HMS-RIC/MyRIO_Breakout/README.md

# MyRIO_Breakout
Breakout board for NI MyRIO. Brings to BNC connectors 4 analog out, 4 analog in and 14 digital IO. Includes 2 channels of lick detection, 2 solenoid drivers and 3 LED drivers

 MyRIO Breakout Board Ver. G2a
