HMS-RIC/MyRIO_Breakout/PCB-Eagle/MyRIO_Breakout_Gamma2b.pdf

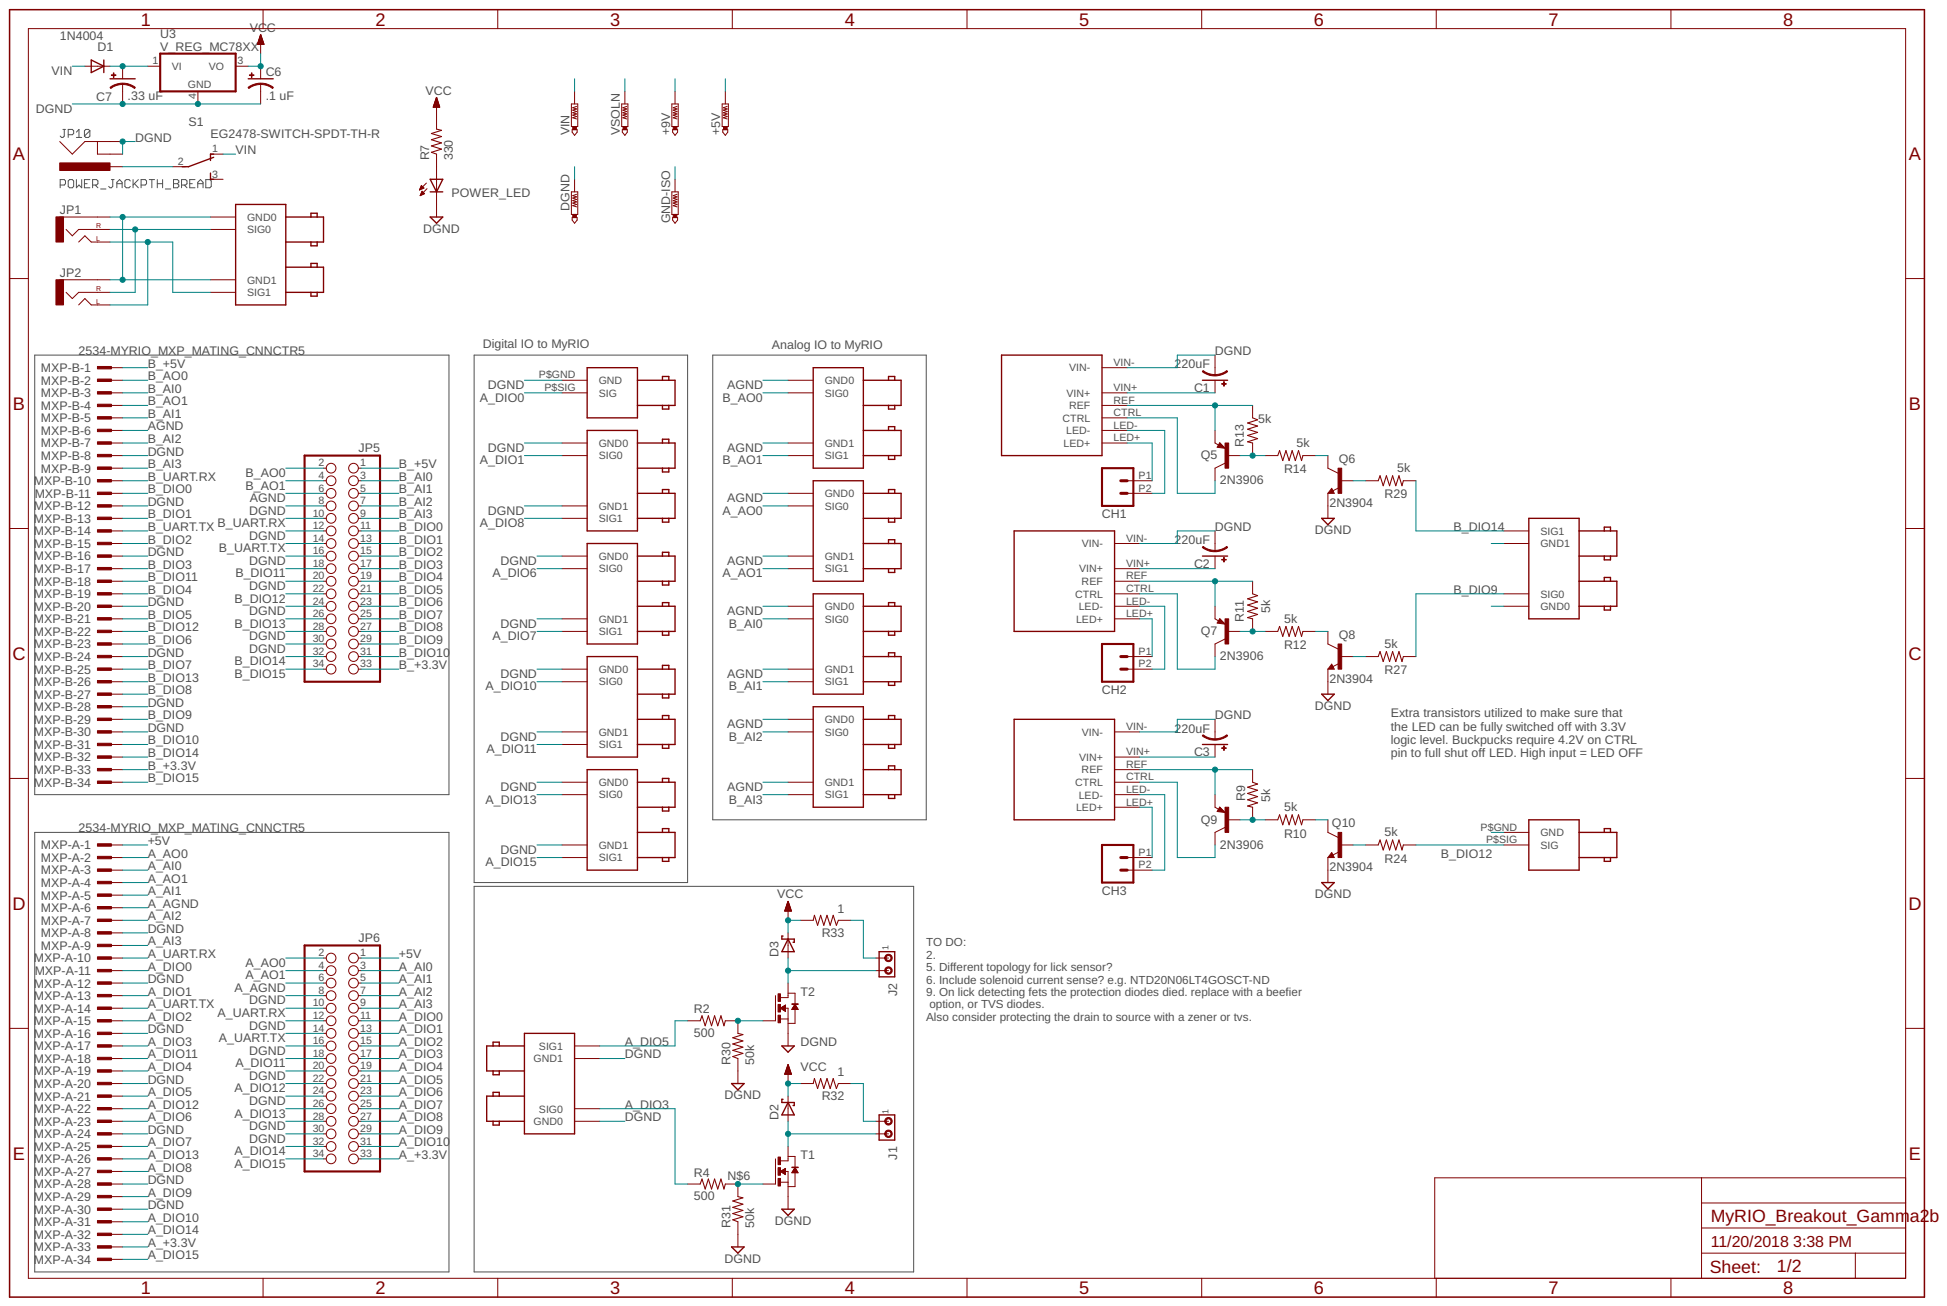
[picture p2: page 1]

1N4004 DGND EG2478-SWITCH-SPDT-TH-R | | | | | DGND

330 Digital IO to MyRIO Analog IO to MyRIO

MXP-B-1 MXP-B-2 MXP-B-3 MXP-B-4 MXP-B-5 MXP-B-6 MXP-B-7 MXP-B-8 MXP-B-9 MXP-B-10 MXP-B-11 MXP-B-12 MXP-B-13 MXP-B-14 MXP-B-15 MXP-B-16 MXP-B-17 MXP-B-18 MXP-B-19 MXP-B-20 MXP-B-21 MXP-B-22 MXP-B-23 MXP-B-24 MXP-B-25 MXP-B-26 MXP-B-27 MXP-B-28 MXP-B-29 MXP-B-30 MXP-B-31 MXP-B-32 MXP-B-33 MXP-B-34

Extra transistors utilized to make sure that
the LED can be fully switched off with 3.3V
logic level. Buckpucks require 4.2V on CTRL
pin to full shut off LED. High input = LED OFF

DGND
B_DIO10
MXP-A-1 MXP-A-2 MXP-A-3 MXP-A-4 MXP-A-5 MXP-A-6 MXP-A-7 MXP-A-8 MXP-A-9 MXP-A-10 MXP-A-11 MXP-A-12 MXP-A-13 MXP-A-14 MXP-A-15 MXP-A-16 MXP-A-17 MXP-A-18 MXP-A-19 MXP-A-20 MXP-A-21 MXP-A-22 MXP-A-23 MXP-A-24 MXP-A-25 MXP-A-26 MXP-A-27 MXP-A-28 MXP-A-29 MXP-A-30 MXP-A-31 MXP-A-32 MXP-A-33 MXP-A-34

TO DO: 2. 5. Different topology for lick sensor?

6. Include solenoid current sense? e.g. NTD20N06LT4GOSCT-ND
9. On lick detecting fets the protection diodes died. replace with a beefier option, or TVS diodes. Also consider protecting the drain to source with a zener or tvs.

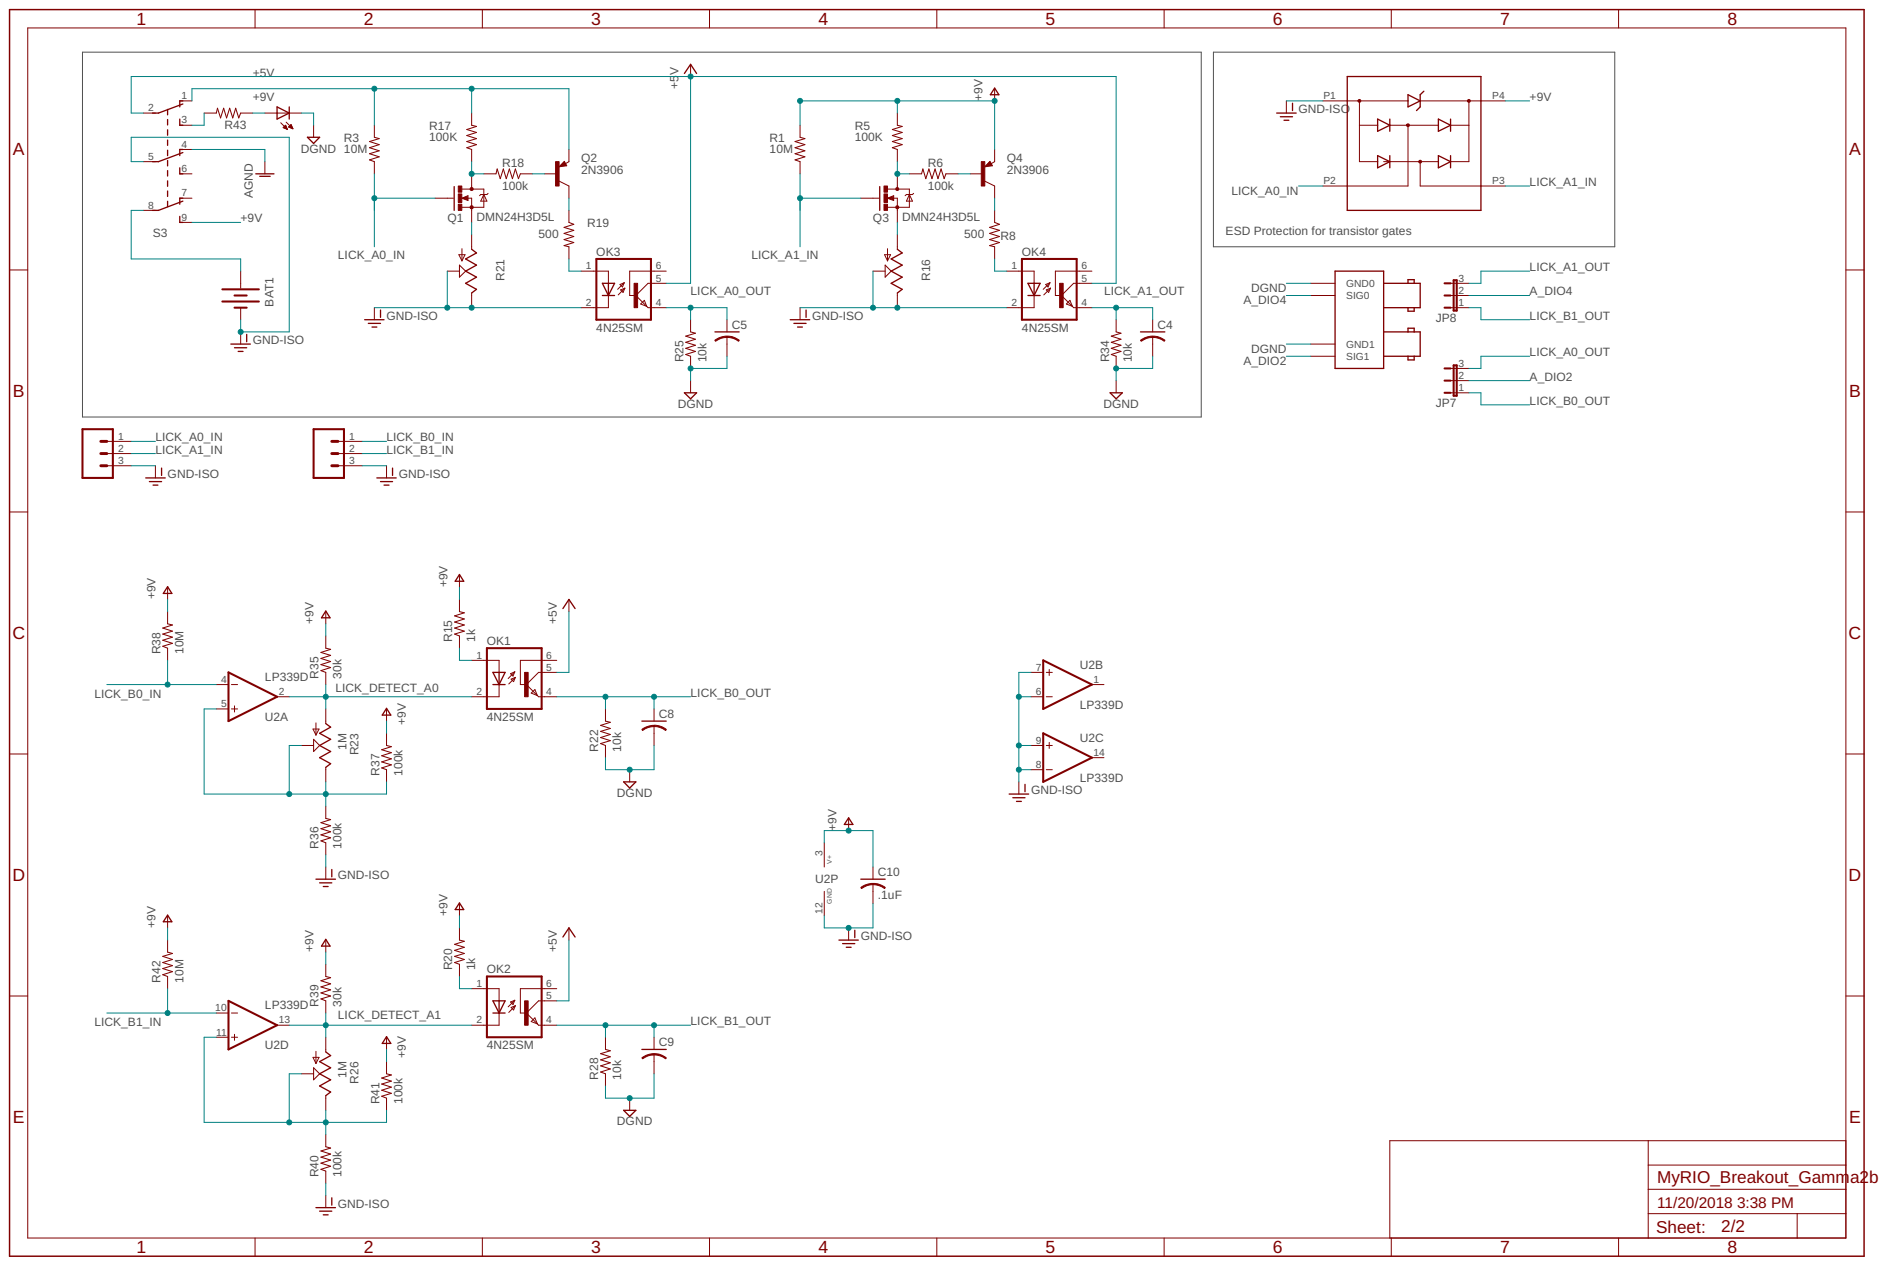
[picture p3: page 2]

ESD Protection for transistor gates BAT1
