HMS-RIC/MyRIO_Breakout/PCB-Eagle/MyRIO_Breakout_Gamma2c_Schematic1.pdf

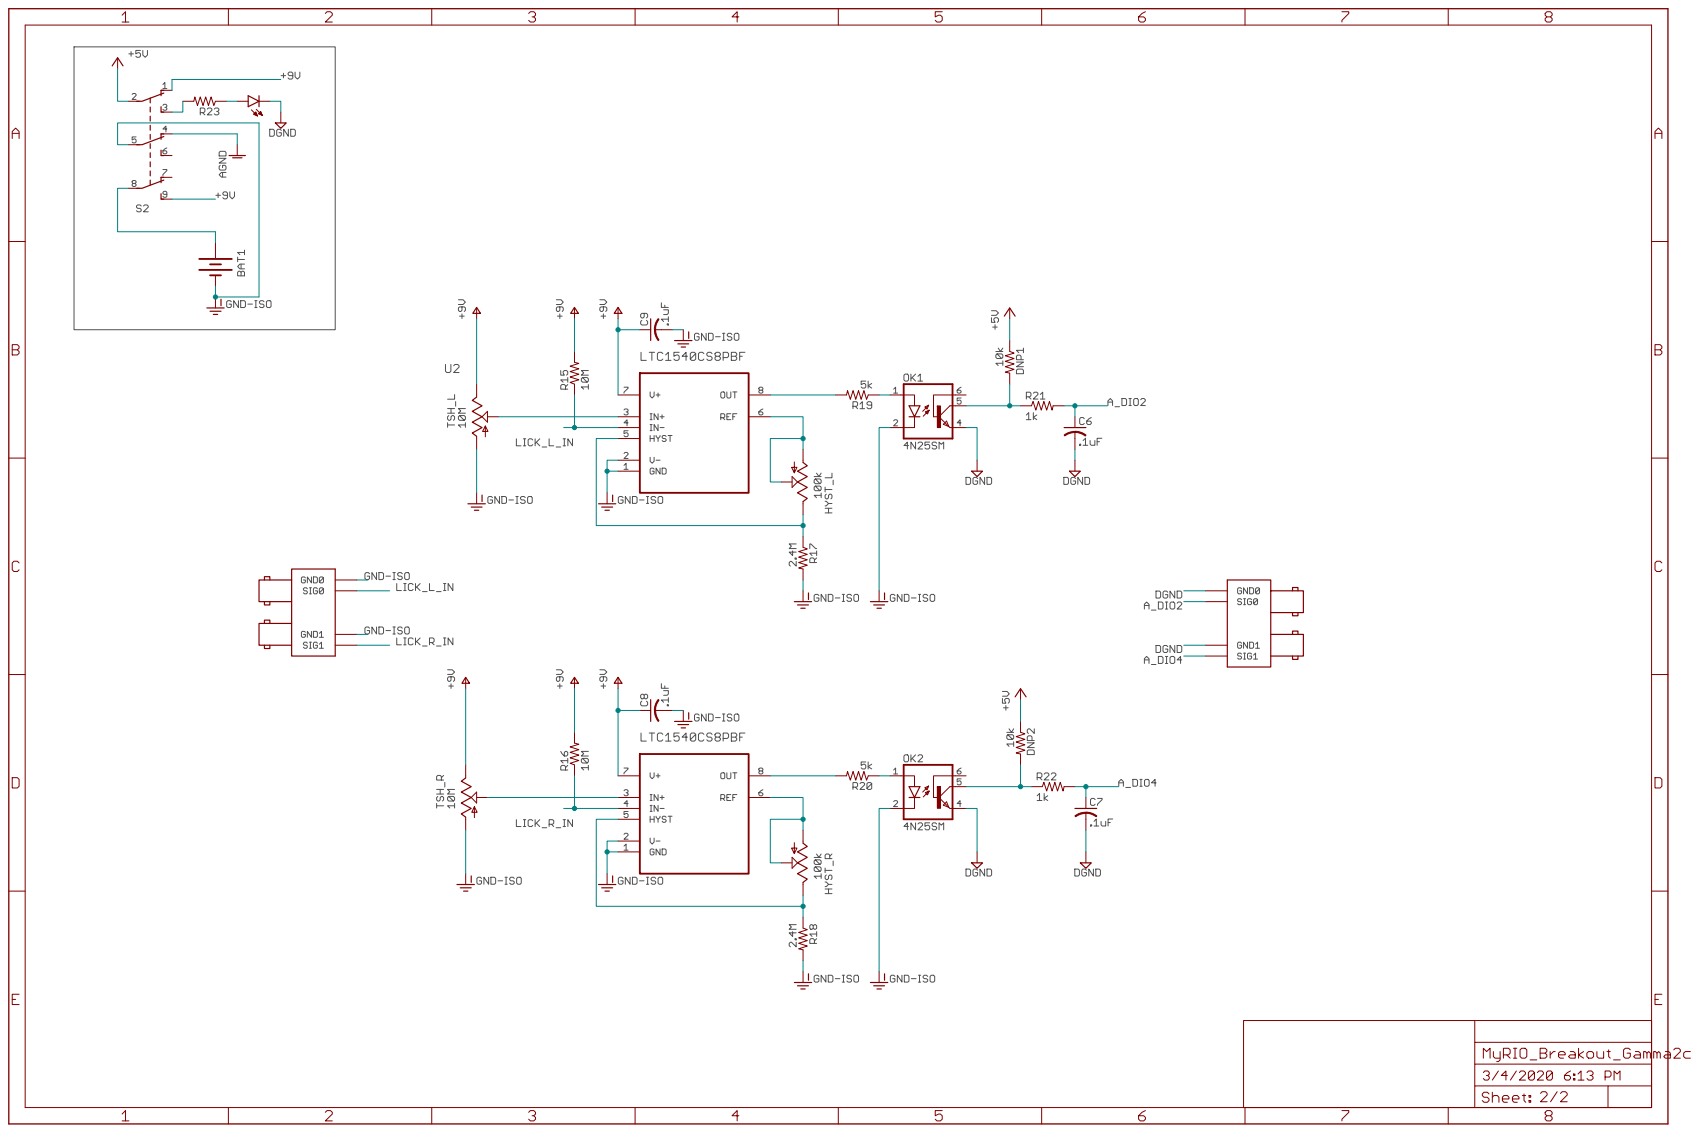
[picture p4: page 1]
