HMS-RIC/MyRIO_Breakout/PCB-Eagle/MyRIO_Breakout_Gamma2c_Schematic2.pdf

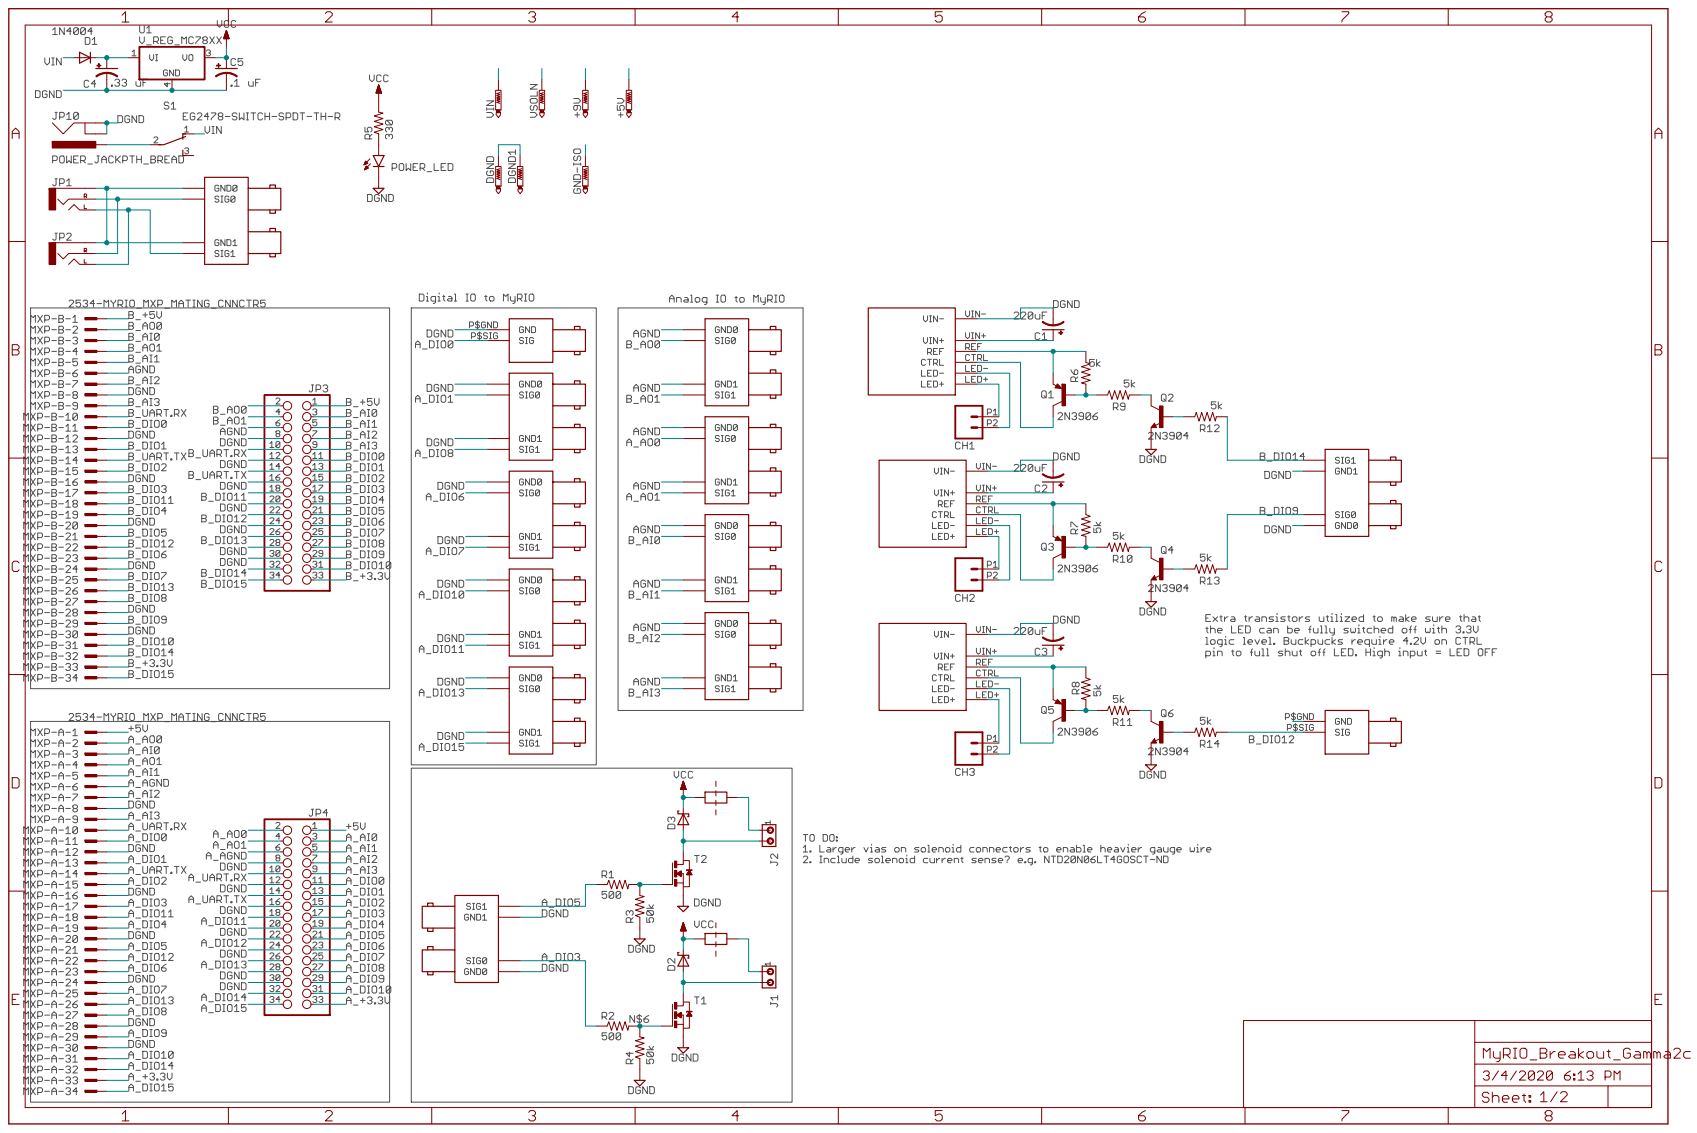
[picture p5: page 1]
