HMS-RIC/MyRIO_Breakout/PCB-Eagle/MyRIO_Breakout_Gamma2d.brd

## EAGLE design PCB-Eagle/MyRIO_Breakout_Gamma2d.brd (2022-01-06)

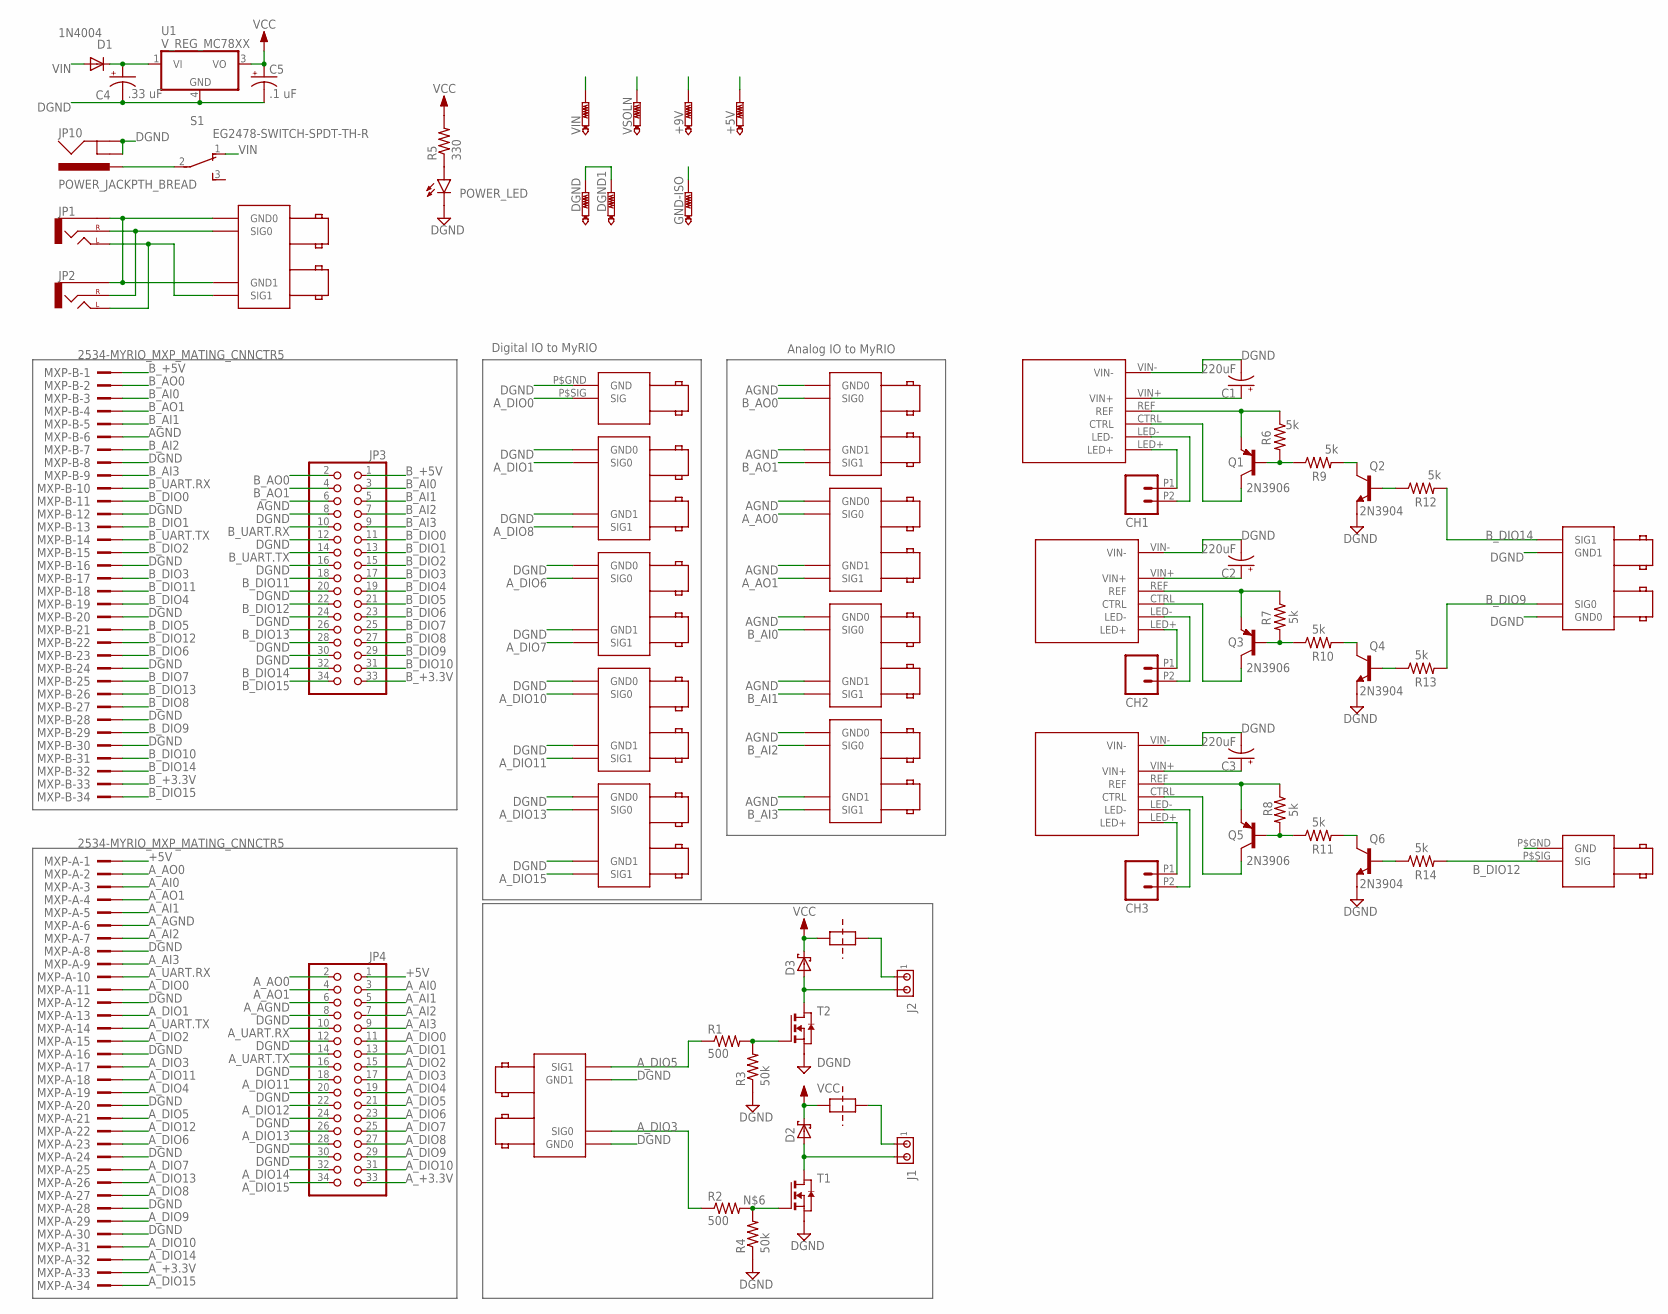
[picture p6: schematic MyRIO_Breakout_Gamma2d.sch, sheet 1]

Parts:
+5V, +9V: PTR1PAD1-13Y; P1-13Y
AAO_0,1: BNC_RIGHT_ANGLE_DOUBLE
ACTV_REC: BNC_RIGHT_ANGLE
AUDIO: BNC_RIGHT_ANGLE_DOUBLE
BAI_0,1, BAI_2,3: BNC_RIGHT_ANGLE_DOUBLE
BAO_0,1: BNC_RIGHT_ANGLE_DOUBLE
BUCKPUCK1, BUCKPUCK2, BUCKPUCK3: BUCKPUCK-350-I; BUCKPUCK_I
C1, C2, C3: 220uF; E5-10,5
C4: .33 uF; E2,5-5
C5: .1 uF; E2,5-5
CAMERA: BNC_RIGHT_ANGLE_DOUBLE
CH1, CH2, CH3: M022.54MM_SCREWTERM; 1X02_2.54_SCREWTERM
D1: 1N4004; DO41-10
D2, D3: SCHOTTKY-DIODE; DIODE_SMB
DGND, DGND1: PTR1PAD1-13Y; P1-13Y
D_FREE1_2, D_FREE3_4: BNC_RIGHT_ANGLE_DOUBLE
GND-ISO: PTR1PAD1-13Y; P1-13Y
J1, J2: MTA02-100; 10X02MTA
JP1, JP2: AUDIO-JACKPTH; AUDIO-JACK
JP3, JP4: PINHD-2X17; 2X17
JP5, JP6: CUTABLE_RESISTOR_JUMPER1206; 1206_WITH_TRACE
JP10: POWER_JACKPTH_BREAD; POWER_JACK_PTH_BREAD
LED_CUE_3: BNC_RIGHT_ANGLE
LED_MASK_1,2: BNC_RIGHT_ANGLE_DOUBLE
MXP-A: 2534-MYRIO_MXP_MATING_CNNCTR5; PAK100/2500-5-34-MXP_CONNCTR
MXP-B: 2534-MYRIO_MXP_MATING_CNNCTR5; PAK100/2500-5-34-MXP_CONNCTR
POWER_LED: LED3MM
Q1, Q3, Q5: 2N3906; SOT23-BEC
Q2, Q4, Q6: 2N3904; SOT23-BEC
R1, R2: 500; M1206
R3, R4: 50k; M1206
R5: 330; 0207/10
R6, R7, R8, R9, R10, R11, R12, R13, R14: 5k; 0805S
S1: EG2478-SWITCH-SPDT-TH-R; ESWITCH_500-SSP1M6
SHUTTER: BNC_RIGHT_ANGLE_DOUBLE
SLN: BNC_RIGHT_ANGLE_DOUBLE
T1, T2: NMOSSOT223; SOT223
U1: V_REG_MC78XX; DPAK
VIN: PTR1PAD1-13Y; P1-13Y
VSOLN: PTR1PAD1-13Y; P1-13Y

Connections:
+5V: +5V.TP, JP4.1, MXP-A.1; also elsewhere on the board
+9V: +9V.TP; also elsewhere on the board
AGND: AAO_0,1.P$GND0 (GND0), AAO_0,1.P$GND1 (GND1), BAI_0,1.P$GND0 (GND0), BAI_0,1.P$GND1 (GND1), BAI_2,3.P$GND0 (GND0), BAI_2,3.P$GND1 (GND1), BAO_0,1.P$GND0 (GND0), BAO_0,1.P$GND1 (GND1), JP3.6, MXP-B.6; also elsewhere on the board
A_+3.3V: JP4.33, MXP-A.33
A_AGND: JP4.6, MXP-A.6
A_AI0: JP4.3, MXP-A.3
A_AI1: JP4.5, MXP-A.5
A_AI2: JP4.7, MXP-A.7
A_AI3: JP4.9, MXP-A.9
A_AO0: AAO_0,1.P$SIG0 (SIG0), JP4.2, MXP-A.2
A_AO1: AAO_0,1.P$SIG1 (SIG1), JP4.4, MXP-A.4
A_DIO0: ACTV_REC.P$SIG (SIG), JP4.11, MXP-A.11
A_DIO1: CAMERA.P$SIG0 (SIG0), JP4.13, MXP-A.13
A_DIO2: JP4.15, MXP-A.15; also elsewhere on the board
A_DIO3: JP4.17, MXP-A.17, R2.1, SLN.P$SIG0 (SIG0)
A_DIO4: JP4.19, MXP-A.19; also elsewhere on the board
A_DIO5: JP4.21, MXP-A.21, R1.1, SLN.P$SIG1 (SIG1)
A_DIO6: JP4.23, MXP-A.23, SHUTTER.P$SIG0 (SIG0)
A_DIO7: JP4.25, MXP-A.25, SHUTTER.P$SIG1 (SIG1)
A_DIO8: CAMERA.P$SIG1 (SIG1), JP4.27, MXP-A.27
A_DIO9: JP4.29, MXP-A.29
A_DIO10: D_FREE1_2.P$SIG0 (SIG0), JP4.31, MXP-A.31
A_DIO11: D_FREE1_2.P$SIG1 (SIG1), JP4.18, MXP-A.18
A_DIO12: JP4.22, MXP-A.22
A_DIO13: D_FREE3_4.P$SIG0 (SIG0), JP4.26, MXP-A.26
A_DIO14: JP4.32, MXP-A.32
A_DIO15: D_FREE3_4.P$SIG1 (SIG1), JP4.34, MXP-A.34
A_UART.RX: JP4.10, MXP-A.10
A_UART.TX: JP4.14, MXP-A.14
BCKPCK_CTRL2: Q4.C, R10.2
BCKPCK_CTRL3: Q6.C, R11.2
B_+3.3V: JP3.33, MXP-B.33
B_+5V: JP3.1, MXP-B.1
B_AI0: BAI_0,1.P$SIG0 (SIG0), JP3.3, MXP-B.3
B_AI1: BAI_0,1.P$SIG1 (SIG1), JP3.5, MXP-B.5
B_AI2: BAI_2,3.P$SIG0 (SIG0), JP3.7, MXP-B.7
B_AI3: BAI_2,3.P$SIG1 (SIG1), JP3.9, MXP-B.9
B_AO0: BAO_0,1.P$SIG0 (SIG0), JP3.2, MXP-B.2
B_AO1: BAO_0,1.P$SIG1 (SIG1), JP3.4, MXP-B.4
B_DIO0: JP3.11, MXP-B.11
B_DIO1: JP3.13, MXP-B.13
B_DIO2: JP3.15, MXP-B.15
B_DIO3: JP3.17, MXP-B.17
B_DIO4: JP3.19, MXP-B.19
B_DIO5: JP3.21, MXP-B.21
B_DIO6: JP3.23, MXP-B.23
B_DIO7: JP3.25, MXP-B.25
B_DIO8: JP3.27, MXP-B.27
B_DIO9: JP3.29, LED_MASK_1,2.P$SIG0 (SIG0), MXP-B.29, R13.2
B_DIO10: JP3.31, MXP-B.31
B_DIO11: JP3.18, MXP-B.18
B_DIO12: JP3.22, LED_CUE_3.P$SIG (SIG), MXP-B.22, R14.2
B_DIO13: JP3.26, MXP-B.26
B_DIO14: JP3.32, LED_MASK_1,2.P$SIG1 (SIG1), MXP-B.32, R12.2
B_DIO15: JP3.34, MXP-B.34
B_UART.RX: JP3.10, MXP-B.10
B_UART.TX: JP3.14, MXP-B.14
CTRL1: BUCKPUCK1.CTRL, Q1.C
CTRL2: BUCKPUCK2.CTRL, Q3.C
CTRL3: BUCKPUCK3.CTRL, Q5.C
DGND: ACTV_REC.P$GND (GND), BUCKPUCK1.LED-, BUCKPUCK1.VIN-, BUCKPUCK2.LED-, BUCKPUCK2.VIN-, BUCKPUCK3.LED-, BUCKPUCK3.VIN-, C1.-, C2.-, C3.-, C4.-, C5.-, CAMERA.P$GND0 (GND0), CAMERA.P$GND1 (GND1), CH1.P2 (2), CH2.P2 (2), CH3.P2 (2), DGND.TP, DGND1.TP, D_FREE1_2.P$GND0 (GND0), D_FREE1_2.P$GND1 (GND1), D_FREE3_4.P$GND0 (GND0), D_FREE3_4.P$GND1 (GND1), JP3.8, JP3.12, JP3.16, JP3.20, JP3.24, JP3.28, JP3.30, JP4.8, JP4.12, JP4.16, JP4.20, JP4.24, JP4.28, JP4.30, JP10.GND, JP10.GNDBREAK, LED_CUE_3.P$GND (GND), LED_MASK_1,2.P$GND0 (GND0), LED_MASK_1,2.P$GND1 (GND1), MXP-A.8, MXP-A.12, MXP-A.16, MXP-A.20, MXP-A.24, MXP-A.28, MXP-A.30, MXP-B.8, MXP-B.12, MXP-B.16, MXP-B.20, MXP-B.24, MXP-B.28, MXP-B.30, POWER_LED.K (C), Q2.E, Q4.E, Q6.E, R3.1, R4.1, SHUTTER.P$GND0 (GND0), SHUTTER.P$GND1 (GND1), SLN.P$GND0 (GND0), SLN.P$GND1 (GND1), T1.3 (S), T2.3 (S), U1.4 (GND); also elsewhere on the board
GND-ISO: GND-ISO.TP; also elsewhere on the board
LED1+: BUCKPUCK1.LED+, CH1.P1 (1)
LED2+: BUCKPUCK2.LED+, CH2.P1 (1)
LED3+: BUCKPUCK3.LED+, CH3.P1 (1)
unnamed: R1.2, R3.2, T2.1 (G)
unnamed: AUDIO.P$GND0 (GND0), AUDIO.P$GND1 (GND1), JP1.SLEEVE, JP2.SLEEVE
unnamed: AUDIO.P$SIG0 (SIG0), JP1.RING (RIGHT), JP2.RING (RIGHT)
unnamed: AUDIO.P$SIG1 (SIG1), JP1.TIP (LEFT), JP2.TIP (LEFT)
unnamed: R2.2, R4.2, T1.1 (G)
unnamed: BUCKPUCK3.REF, Q5.E, R8.1
unnamed: POWER_LED.A, R5.1
unnamed: Q5.B, R8.2, R11.1
unnamed: BUCKPUCK1.VIN+, BUCKPUCK2.VIN+, BUCKPUCK3.VIN+, C1.+, C2.+, C3.+, C4.+, D1.C, U1.1 (VI), VIN.TP
unnamed: BUCKPUCK1.REF, Q1.E, R6.1
unnamed: BUCKPUCK2.REF, Q3.E, R7.1
unnamed: Q6.B, R14.1
unnamed: Q4.B, R13.1
unnamed: Q1.B, R6.2, R9.1
unnamed: Q2.B, R12.1
unnamed: J1.1, JP6.2
unnamed: Q3.B, R7.2, R10.1
unnamed: JP10.PWR, S1.2
unnamed: J2.1, JP5.2
unnamed: Q2.C, R9.2
VCC: C5.+, D2.C (A), D3.C (A), JP5.1, JP6.1, R5.2, U1.3 (VO), VSOLN.TP
VIN: D1.A, S1.1
VOUT-1: D2.A (C), J1.2, T1.2 (D), T1.4 (D)
VOUT-2: D3.A (C), J2.2, T2.2 (D), T2.4 (D)

Notes on the sheet:
Digital IO to MyRIO
Analog IO to MyRIO

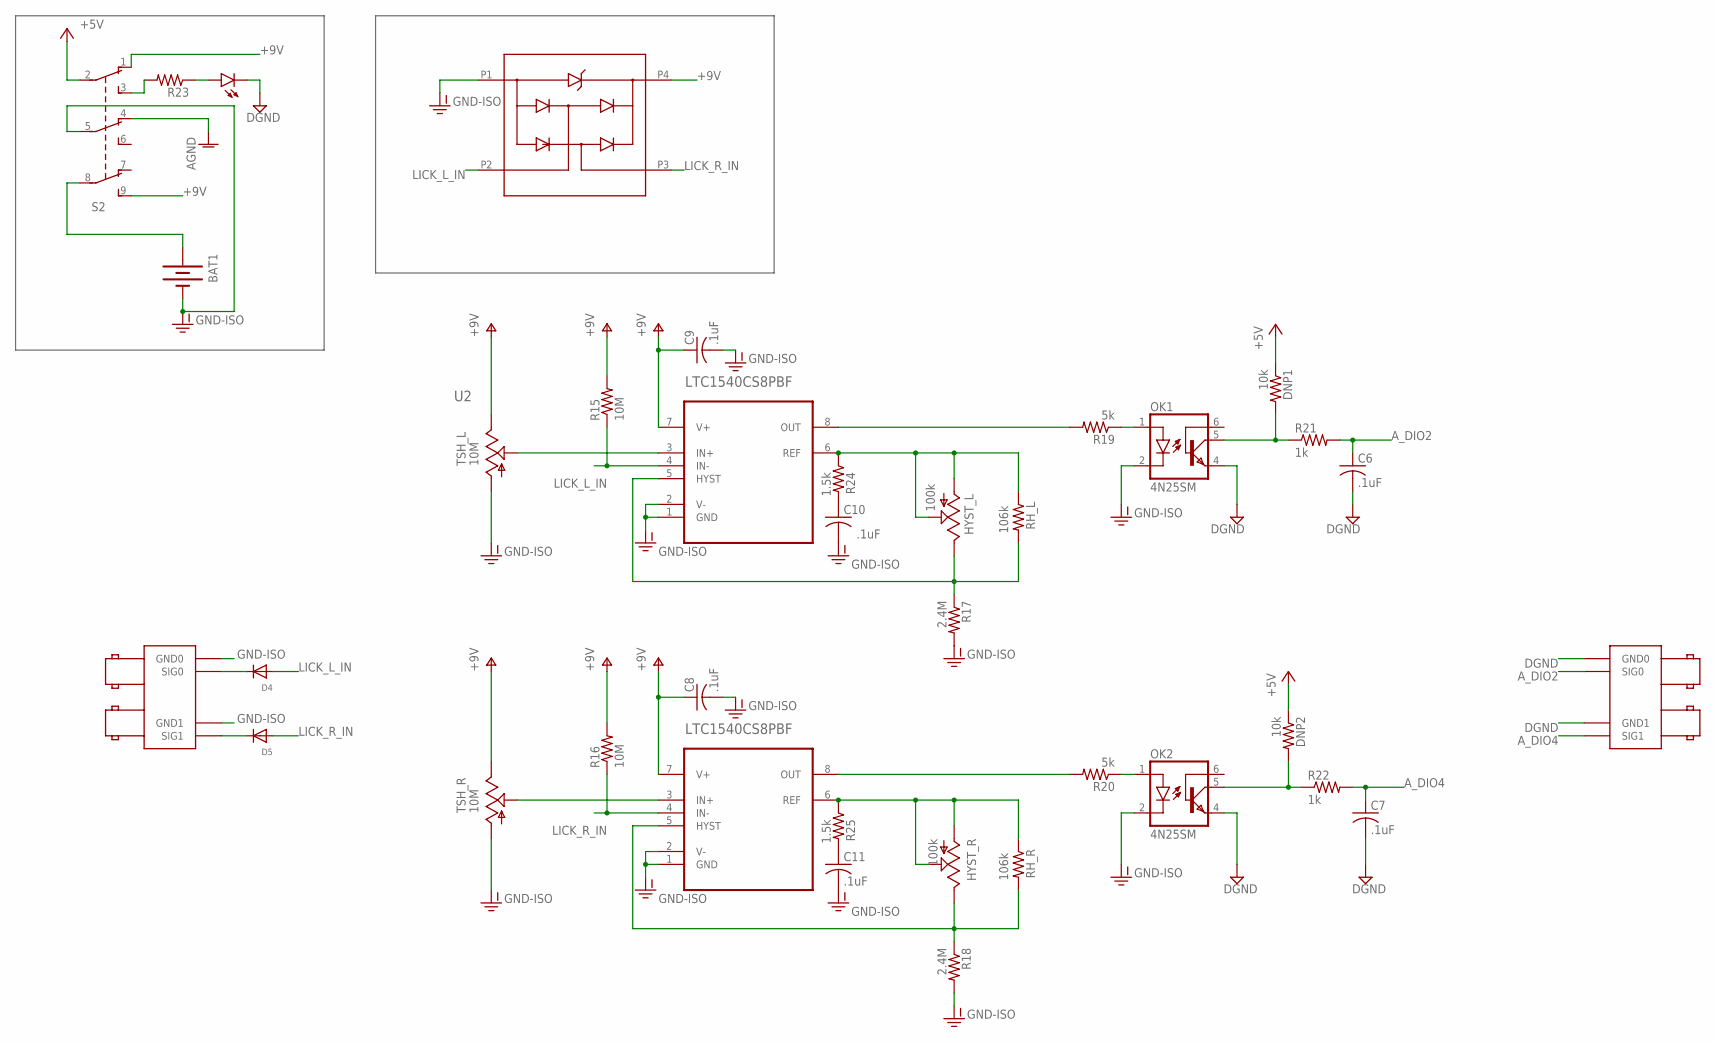
[picture p7: schematic MyRIO_Breakout_Gamma2d.sch, sheet 2]

Parts:
BAT1: BATTERY9V; BATTCON_9V
C6, C7, C8, C9, C10, C11: .1uF; C0805
D4, D5: DIODE_SOD-123FL; SOD-123FL
DNP1, DNP2: 10k; M0805
HYST_L: 100k; B25P
HYST_R: 100k; B25P
ISOLATED: LED3MM
LICK: BNC_RIGHT_ANGLE_DOUBLE
LICK_INPUTS: BNC_RIGHT_ANGLE_DOUBLE
OK1, OK2: 4N25SM; DIL6-SMD
R15, R16: 10M; M0805
R17, R18: 2.4M; M0805
R19, R20: 5k; M0805
R21, R22: 1k; M0805
R23: 330; 0207/10
R24, R25: 1.5k; M0805
RH_L: 106k; M0805
RH_R: 106k; M0805
S2: SWITCH-3PDT-TH-V; NKK-M20-9PIN-VERTICAL
TSH_L: 10M; B25P
TSH_R: 10M; B25P
U2, U3: LTC1540CS8PBF; SOIC127P600X175-8N
U$1: CD143A-12_TVS; SOT-143

Connections:
+5V: DNP1.1, DNP2.1, S2.2 (P1); also elsewhere on the board
+9V: C8.1, C9.1, R15.2, R16.2, S2.1 (O1), S2.9 (S3), TSH_L.E, TSH_R.E, U2.7 (V+), U3.7 (V+), U$1.P4; also elsewhere on the board
AGND: S2.4 (O2); also elsewhere on the board
A_DIO2: C6.1, LICK.P$SIG0 (SIG0), R21.2; also elsewhere on the board
A_DIO4: C7.1, LICK.P$SIG1 (SIG1), R22.2; also elsewhere on the board
DGND: C6.2, C7.2, ISOLATED.K (C), LICK.P$GND0 (GND0), LICK.P$GND1 (GND1), OK1.4 (EMI), OK2.4 (EMI); also elsewhere on the board
GND-ISO: BAT1.-, C8.2, C9.2, C10.2, C11.2, LICK_INPUTS.P$GND0 (GND0), LICK_INPUTS.P$GND1 (GND1), OK1.2 (C), OK2.2 (C), R17.2, R18.2, S2.5 (P2), TSH_L.A, TSH_R.A, U2.1 (GND), U2.2 (V-), U3.1 (GND), U3.2 (V-), U$1.P1; also elsewhere on the board
LICK_L_IN: D4.A, R15.1, U2.4 (IN-), U$1.P2
LICK_R_IN: D5.A, R16.1, U3.4 (IN-), U$1.P3
unnamed: D4.C, LICK_INPUTS.P$SIG0 (SIG0)
unnamed: C10.1, R24.2
unnamed: D5.C, LICK_INPUTS.P$SIG1 (SIG1)
unnamed: C11.1, R25.2
unnamed: BAT1.+, S2.8 (P3)
unnamed: ISOLATED.A, R23.1
unnamed: TSH_R.S, U3.3 (IN+)
unnamed: R23.2, S2.3 (S1)
unnamed: OK1.1 (A), R19.1
unnamed: R19.2, U2.8 (OUT)
unnamed: DNP1.2, OK1.5 (COL), R21.1
unnamed: HYST_L.A, HYST_L.S, R24.1, RH_L.1, U2.6 (REF)
unnamed: HYST_L.E, R17.1, RH_L.2, U2.5 (HYST)
unnamed: OK2.1 (A), R20.1
unnamed: R20.2, U3.8 (OUT)
unnamed: TSH_L.S, U2.3 (IN+)
unnamed: DNP2.2, OK2.5 (COL), R22.1
unnamed: HYST_R.A, HYST_R.S, R25.1, RH_R.1, U3.6 (REF)
unnamed: HYST_R.E, R18.1, RH_R.2, U3.5 (HYST)

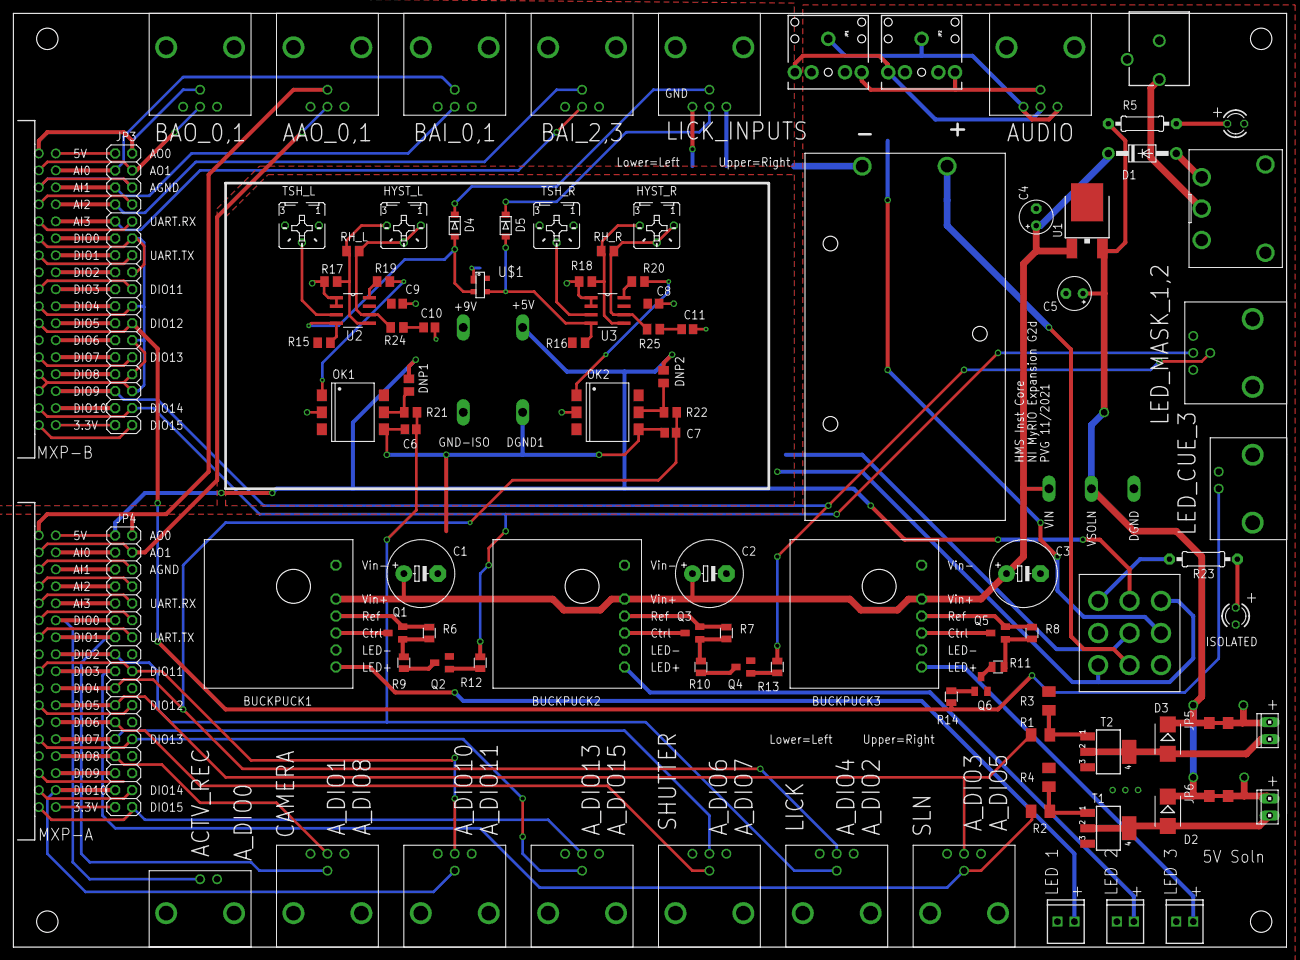
[picture p8: board MyRIO_Breakout_Gamma2d.brd from above]

Board: 2 copper layers, 190.5 x 139.7 mm, 107 parts (0 on the bottom side), 110 nets.
