HMS-RIC/MyRIO_Breakout/PCB-Eagle/MyRIO_Breakout_Gamma2b.brd

## EAGLE design PCB-Eagle/MyRIO_Breakout_Gamma2b.brd (2018-11-27)

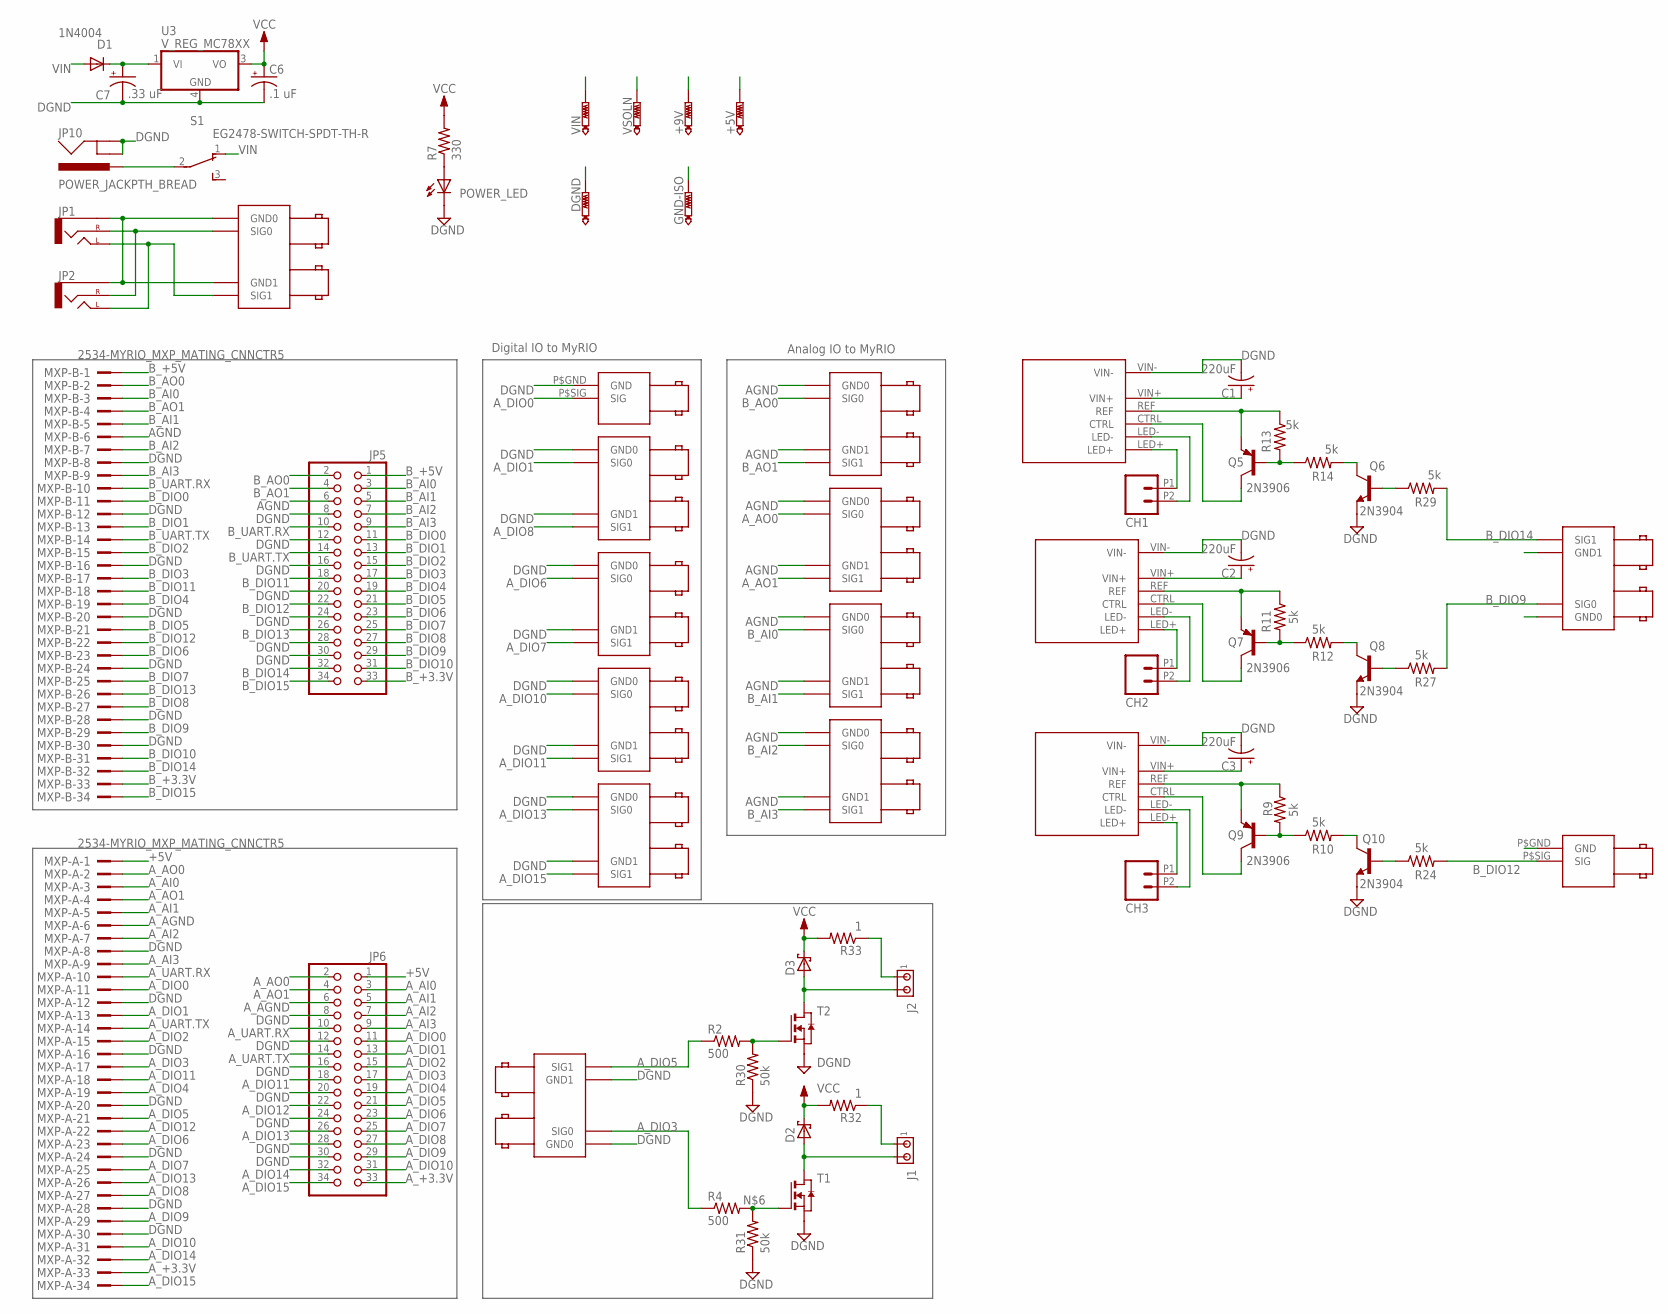
[picture p9: schematic MyRIO_Breakout_Gamma2b.sch, sheet 1]

Parts:
+5V, +9V: PTR1PAD1-17Y; P1-17Y
AAO_0,1: BNC_RIGHT_ANGLE_DOUBLE
ACTV_REC: BNC_RIGHT_ANGLE
AUDIO: BNC_RIGHT_ANGLE_DOUBLE
BAI_0,1, BAI_2,3: BNC_RIGHT_ANGLE_DOUBLE
BAO_0,1: BNC_RIGHT_ANGLE_DOUBLE
BUCKPUCK1, BUCKPUCK2, BUCKPUCK3: BUCKPUCK-350-I; BUCKPUCK_I
C1, C2, C3: 220uF; E5-10,5
C6: .1 uF; E2,5-5
C7: .33 uF; E2,5-5
CAMERA: BNC_RIGHT_ANGLE_DOUBLE
CH1, CH2, CH3: M022.54MM_SCREWTERM; 1X02_2.54_SCREWTERM
D1: 1N4004; DO41-10
D2, D3: SCHOTTKY-DIODE; DIODE_SMB
DGND: PTR1PAD1-17Y; P1-17Y
D_FREE1_2, D_FREE3_4: BNC_RIGHT_ANGLE_DOUBLE
GND-ISO: PTR1PAD1-17Y; P1-17Y
J1, J2: MTA02-100; 10X02MTA
JP1, JP2: AUDIO-JACKPTH; AUDIO-JACK
JP5, JP6: PINHD-2X17; 2X17
JP10: POWER_JACKPTH_BREAD; POWER_JACK_PTH_BREAD
LED_CUE: BNC_RIGHT_ANGLE
LED_MASK: BNC_RIGHT_ANGLE_DOUBLE
MXP-A: 2534-MYRIO_MXP_MATING_CNNCTR5; PAK100/2500-5-34-MXP_CONNCTR
MXP-B: 2534-MYRIO_MXP_MATING_CNNCTR5; PAK100/2500-5-34-MXP_CONNCTR
POWER_LED: LED3MM
Q5, Q7, Q9: 2N3906; SOT23-BEC
Q6, Q8, Q10: 2N3904; SOT23-BEC
R2, R4: 500; M1206
R7: 330; 0207/10
R9, R10, R11, R12, R13, R14, R24, R27, R29: 5k; 0805S
R30, R31: 50k; M1206
R32, R33: 1; M1206
S1: EG2478-SWITCH-SPDT-TH-R; ESWITCH_500-SSP1M6
SHUTTER: BNC_RIGHT_ANGLE_DOUBLE
SLN: BNC_RIGHT_ANGLE_DOUBLE
T1, T2: NMOSSOT223; SOT223
U3: V_REG_MC78XX; DPAK
VIN: PTR1PAD1-17Y; P1-17Y
VSOLN: PTR1PAD1-17Y; P1-17Y

Connections:
+5V: +5V.TP, JP6.1, MXP-A.1; also elsewhere on the board
+9V: +9V.TP; also elsewhere on the board
AGND: AAO_0,1.P$GND0 (GND0), AAO_0,1.P$GND1 (GND1), BAI_0,1.P$GND0 (GND0), BAI_0,1.P$GND1 (GND1), BAI_2,3.P$GND0 (GND0), BAI_2,3.P$GND1 (GND1), BAO_0,1.P$GND0 (GND0), BAO_0,1.P$GND1 (GND1), JP5.6, MXP-B.6; also elsewhere on the board
A_+3.3V: JP6.33, MXP-A.33
A_AGND: JP6.6, MXP-A.6
A_AI0: JP6.3, MXP-A.3
A_AI1: JP6.5, MXP-A.5
A_AI2: JP6.7, MXP-A.7
A_AI3: JP6.9, MXP-A.9
A_AO0: AAO_0,1.P$SIG0 (SIG0), JP6.2, MXP-A.2
A_AO1: AAO_0,1.P$SIG1 (SIG1), JP6.4, MXP-A.4
A_DIO0: ACTV_REC.P$SIG (SIG), JP6.11, MXP-A.11
A_DIO1: CAMERA.P$SIG0 (SIG0), JP6.13, MXP-A.13
A_DIO2: JP6.15, MXP-A.15; also elsewhere on the board
A_DIO3: JP6.17, MXP-A.17, R4.1, SLN.P$SIG0 (SIG0)
A_DIO4: JP6.19, MXP-A.19; also elsewhere on the board
A_DIO5: JP6.21, MXP-A.21, R2.1, SLN.P$SIG1 (SIG1)
A_DIO6: JP6.23, MXP-A.23, SHUTTER.P$SIG0 (SIG0)
A_DIO7: JP6.25, MXP-A.25, SHUTTER.P$SIG1 (SIG1)
A_DIO8: CAMERA.P$SIG1 (SIG1), JP6.27, MXP-A.27
A_DIO9: JP6.29, MXP-A.29
A_DIO10: D_FREE1_2.P$SIG0 (SIG0), JP6.31, MXP-A.31
A_DIO11: D_FREE1_2.P$SIG1 (SIG1), JP6.18, MXP-A.18
A_DIO12: JP6.22, MXP-A.22
A_DIO13: D_FREE3_4.P$SIG0 (SIG0), JP6.26, MXP-A.26
A_DIO14: JP6.32, MXP-A.32
A_DIO15: D_FREE3_4.P$SIG1 (SIG1), JP6.34, MXP-A.34
A_UART.RX: JP6.10, MXP-A.10
A_UART.TX: JP6.14, MXP-A.14
BCKPCK_CTRL2: Q8.C, R12.2
BCKPCK_CTRL3: Q10.C, R10.2
B_+3.3V: JP5.33, MXP-B.33
B_+5V: JP5.1, MXP-B.1
B_AI0: BAI_0,1.P$SIG0 (SIG0), JP5.3, MXP-B.3
B_AI1: BAI_0,1.P$SIG1 (SIG1), JP5.5, MXP-B.5
B_AI2: BAI_2,3.P$SIG0 (SIG0), JP5.7, MXP-B.7
B_AI3: BAI_2,3.P$SIG1 (SIG1), JP5.9, MXP-B.9
B_AO0: BAO_0,1.P$SIG0 (SIG0), JP5.2, MXP-B.2
B_AO1: BAO_0,1.P$SIG1 (SIG1), JP5.4, MXP-B.4
B_DIO0: JP5.11, MXP-B.11
B_DIO1: JP5.13, MXP-B.13
B_DIO2: JP5.15, MXP-B.15
B_DIO3: JP5.17, MXP-B.17
B_DIO4: JP5.19, MXP-B.19
B_DIO5: JP5.21, MXP-B.21
B_DIO6: JP5.23, MXP-B.23
B_DIO7: JP5.25, MXP-B.25
B_DIO8: JP5.27, MXP-B.27
B_DIO9: JP5.29, LED_MASK.P$SIG0 (SIG0), MXP-B.29, R27.2
B_DIO10: JP5.31, MXP-B.31
B_DIO11: JP5.18, MXP-B.18
B_DIO12: JP5.22, LED_CUE.P$SIG (SIG), MXP-B.22, R24.2
B_DIO13: JP5.26, MXP-B.26
B_DIO14: JP5.32, LED_MASK.P$SIG1 (SIG1), MXP-B.32, R29.2
B_DIO15: JP5.34, MXP-B.34
B_UART.RX: JP5.10, MXP-B.10
B_UART.TX: JP5.14, MXP-B.14
CTRL1: BUCKPUCK1.CTRL, Q5.C
CTRL2: BUCKPUCK2.CTRL, Q7.C
CTRL3: BUCKPUCK3.CTRL, Q9.C
DGND: ACTV_REC.P$GND (GND), BUCKPUCK1.LED-, BUCKPUCK1.VIN-, BUCKPUCK2.LED-, BUCKPUCK2.VIN-, BUCKPUCK3.LED-, BUCKPUCK3.VIN-, C1.-, C2.-, C3.-, C6.-, C7.-, CAMERA.P$GND0 (GND0), CAMERA.P$GND1 (GND1), CH1.P2 (2), CH2.P2 (2), CH3.P2 (2), DGND.TP, D_FREE1_2.P$GND0 (GND0), D_FREE1_2.P$GND1 (GND1), D_FREE3_4.P$GND0 (GND0), D_FREE3_4.P$GND1 (GND1), JP5.8, JP5.12, JP5.16, JP5.20, JP5.24, JP5.28, JP5.30, JP6.8, JP6.12, JP6.16, JP6.20, JP6.24, JP6.28, JP6.30, JP10.GND, JP10.GNDBREAK, LED_CUE.P$GND (GND), LED_MASK.P$GND0 (GND0), LED_MASK.P$GND1 (GND1), MXP-A.8, MXP-A.12, MXP-A.16, MXP-A.20, MXP-A.24, MXP-A.28, MXP-A.30, MXP-B.8, MXP-B.12, MXP-B.16, MXP-B.20, MXP-B.24, MXP-B.28, MXP-B.30, POWER_LED.K (C), Q6.E, Q8.E, Q10.E, R30.1, R31.1, SHUTTER.P$GND0 (GND0), SHUTTER.P$GND1 (GND1), SLN.P$GND0 (GND0), SLN.P$GND1 (GND1), T1.3 (S), T2.3 (S), U3.4 (GND); also elsewhere on the board
GND-ISO: GND-ISO.TP; also elsewhere on the board
LED1+: BUCKPUCK1.LED+, CH1.P1 (1)
LED2+: BUCKPUCK2.LED+, CH2.P1 (1)
LED3+: BUCKPUCK3.LED+, CH3.P1 (1)
unnamed: R2.2, R30.2, T2.1 (G)
unnamed: AUDIO.P$GND0 (GND0), AUDIO.P$GND1 (GND1), JP1.SLEEVE, JP2.SLEEVE
unnamed: AUDIO.P$SIG0 (SIG0), JP1.RING (RIGHT), JP2.RING (RIGHT)
unnamed: AUDIO.P$SIG1 (SIG1), JP1.TIP (LEFT), JP2.TIP (LEFT)
unnamed: R4.2, R31.2, T1.1 (G)
unnamed: BUCKPUCK3.REF, Q9.E, R9.1
unnamed: POWER_LED.A, R7.1
unnamed: Q9.B, R9.2, R10.1
unnamed: BUCKPUCK1.VIN+, BUCKPUCK2.VIN+, BUCKPUCK3.VIN+, C1.+, C2.+, C3.+, C7.+, D1.C, U3.1 (VI), VIN.TP
unnamed: BUCKPUCK1.REF, Q5.E, R13.1
unnamed: BUCKPUCK2.REF, Q7.E, R11.1
unnamed: Q10.B, R24.1
unnamed: Q8.B, R27.1
unnamed: Q5.B, R13.2, R14.1
unnamed: Q6.B, R29.1
unnamed: J1.1, R32.1
unnamed: Q7.B, R11.2, R12.1
unnamed: JP10.PWR, S1.2
unnamed: J2.1, R33.1
unnamed: Q6.C, R14.2
VCC: C6.+, D2.C (A), D3.C (A), R7.2, R32.2, R33.2, U3.3 (VO), VSOLN.TP
VIN: D1.A, S1.1
VOUT-1: D2.A (C), J1.2, T1.2 (D), T1.4 (D)
VOUT-2: D3.A (C), J2.2, T2.2 (D), T2.4 (D)

Notes on the sheet:
Digital IO to MyRIO
Analog IO to MyRIO

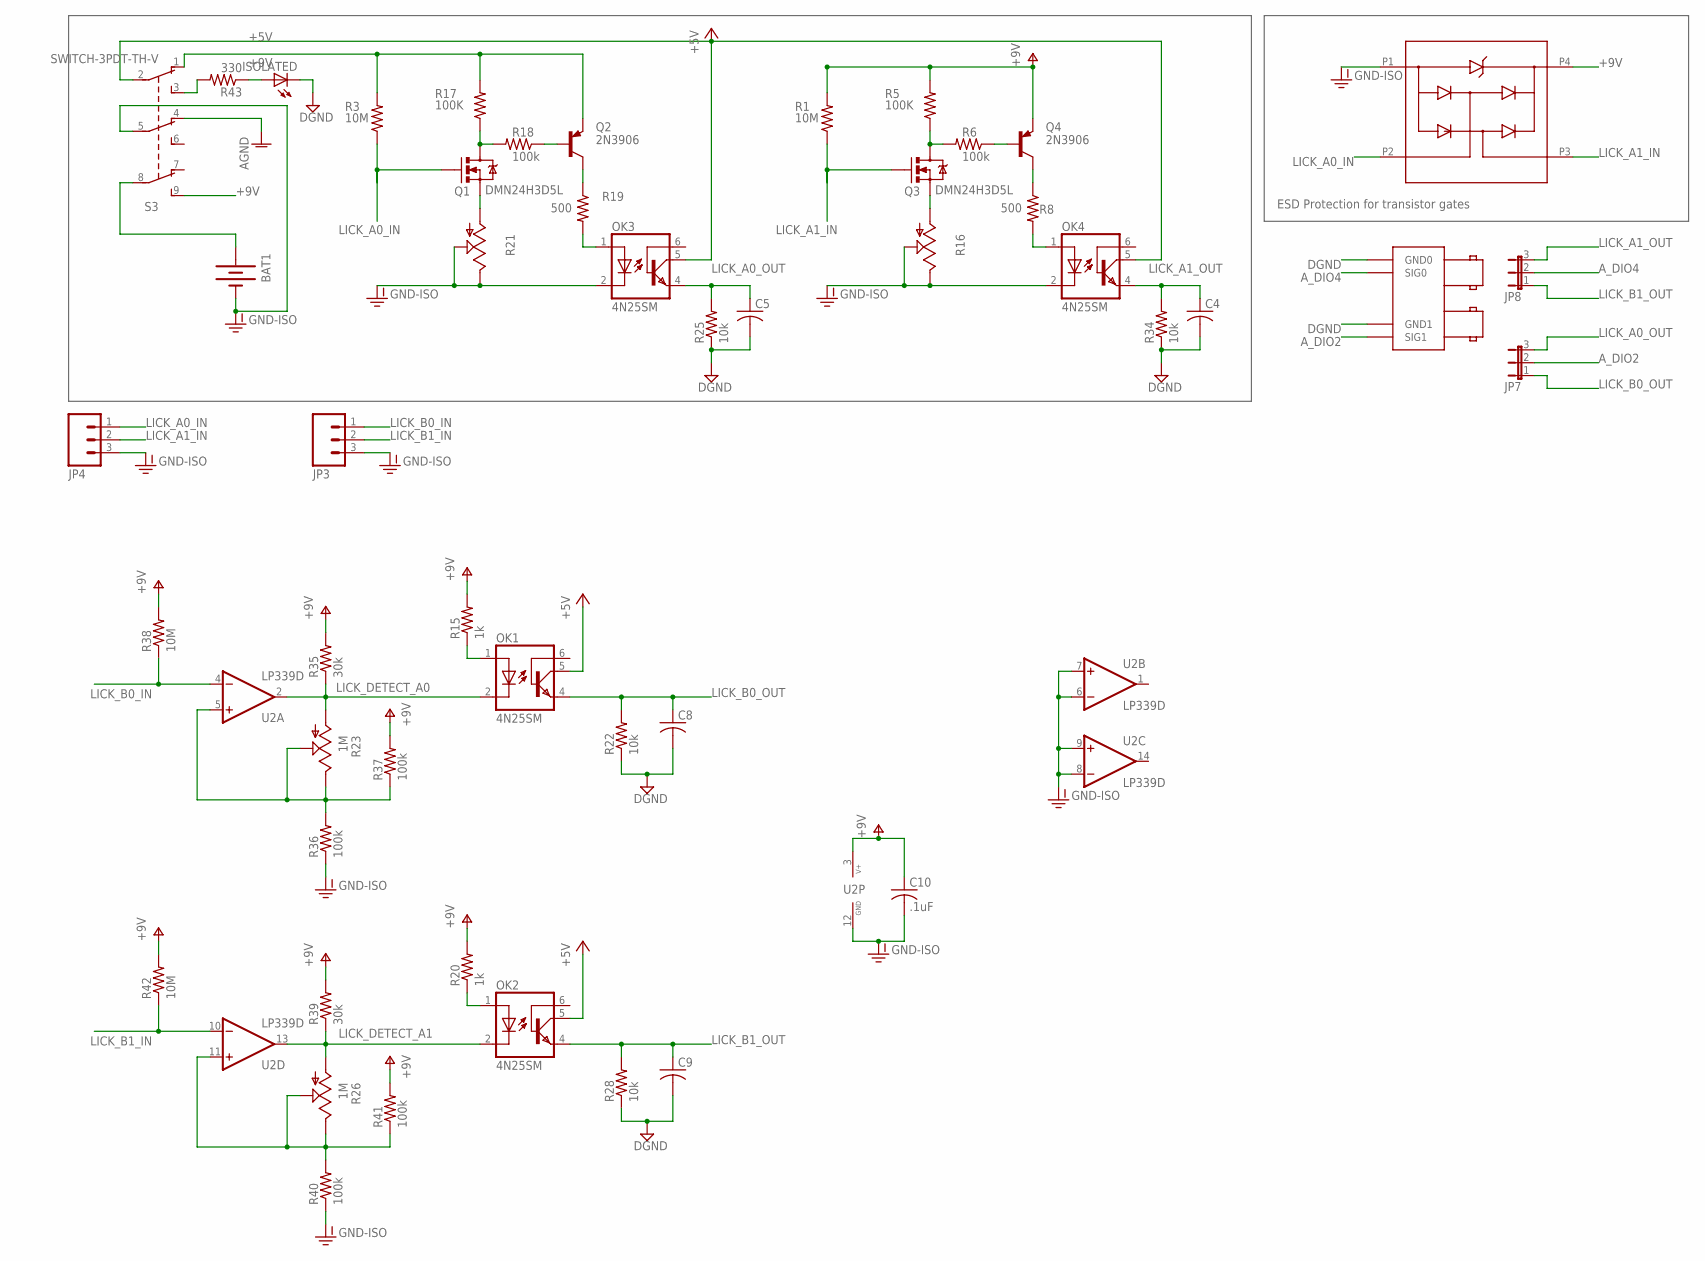
[picture p10: schematic MyRIO_Breakout_Gamma2b.sch, sheet 2]

Parts:
BAT1: BATTERY9V; BATTCON_9V
C4, C5, C8, C9: C-US025-024X044; C025-024X044
C10: .1uF; C0805K
ISOLATED: LED3MM
JP3, JP4: M03POLAR; MOLEX-1X3
JP7, JP8: JP2E; JP2
LICK: BNC_RIGHT_ANGLE_DOUBLE
OK1, OK2, OK3, OK4: 4N25SM; DIL6-SMD
Q1, Q3: DMN24H3D5L; SOT23-3
Q2, Q4: 2N3906; SOT23-BEC
R1, R3: 10M; 0805S
R5, R17: 100K; 0805S
R6, R18: 100k; 0805S
R8, R19: 500; 0805S
R15, R20: 1k; M0805
R16, R21: TRIM_US-B25P; B25P
R22, R25, R28, R34: 10k; 0204V
R23, R26: 1M; B25P
R35, R39: 30k; M0805
R36, R37, R40, R41: 100k; M0805
R38, R42: 10M; M0805
R43: 330; 0207/10
S3: SWITCH-3PDT-TH-V; NKK-M20-9PIN-VERTICAL
U1: CD143A-12_TVS; SOT-143
U2: LP339D; SO14

Connections:
+5V: OK1.5 (COL), OK2.5 (COL), OK3.5 (COL), OK4.5 (COL), S3.2 (P1); also elsewhere on the board
+9V: C10.1, Q2.E, Q4.E, R1.2, R3.2, R5.2, R15.2, R17.2, R20.2, R35.2, R37.2, R38.2, R39.2, R41.2, R42.2, S3.1 (O1), S3.9 (S3), U1.P4, U2.3 (V+); also elsewhere on the board
AGND: S3.4 (O2); also elsewhere on the board
A_DIO2: JP7.2, LICK.P$SIG1 (SIG1); also elsewhere on the board
A_DIO4: JP8.2, LICK.P$SIG0 (SIG0); also elsewhere on the board
DGND: C4.2, C5.2, C8.2, C9.2, ISOLATED.K (C), LICK.P$GND0 (GND0), LICK.P$GND1 (GND1), R22.1, R25.1, R28.1, R34.1; also elsewhere on the board
GND-ISO: BAT1.-, C10.2, JP3.3, JP4.3, OK3.2 (C), OK4.2 (C), R16.E, R16.S, R21.E, R21.S, R36.1, R40.1, S3.5 (P2), U1.P1, U2.6 (-IN), U2.7 (+IN), U2.8 (-IN), U2.9 (+IN), U2.12 (GND); also elsewhere on the board
LICK_A0_IN: JP4.1, Q1.1 (G), R3.1, U1.P2
LICK_A0_OUT: C5.1, JP7.3, OK3.4 (EMI), R25.2
LICK_A1_IN: JP4.2, Q3.1 (G), R1.1, U1.P3
LICK_A1_OUT: C4.1, JP8.3, OK4.4 (EMI), R34.2
LICK_B0_IN: JP3.1, R38.1, U2.4 (-IN)
LICK_B0_OUT: C8.1, JP7.1, OK1.4 (EMI), R22.2
LICK_B1_IN: JP3.2, R42.1, U2.10 (-IN)
LICK_B1_OUT: C9.1, JP8.1, OK2.4 (EMI), R28.2
LICK_DETECT_A0: OK1.2 (C), R23.A, R35.1, U2.2 (OUT)
LICK_DETECT_A1: OK2.2 (C), R26.A, R39.1, U2.13 (OUT)
unnamed: Q1.3 (D), R17.1, R18.2
unnamed: Q3.3 (D), R5.1, R6.2
unnamed: Q4.B, R6.1
unnamed: OK4.1 (A), R8.2
unnamed: Q4.C, R8.1
unnamed: Q3.2 (S), R16.A
unnamed: Q2.B, R18.1
unnamed: OK3.1 (A), R19.2
unnamed: Q2.C, R19.1
unnamed: Q1.2 (S), R21.A
unnamed: BAT1.+, S3.8 (P3)
unnamed: ISOLATED.A, R43.1
unnamed: OK2.1 (A), R20.1
unnamed: R43.2, S3.3 (S1)
unnamed: OK1.1 (A), R15.1
unnamed: R23.E, R23.S, R36.2, R37.1, U2.5 (+IN)
unnamed: R26.E, R26.S, R40.2, R41.1, U2.11 (+IN)

Notes on the sheet:
ESD Protection for transistor gates

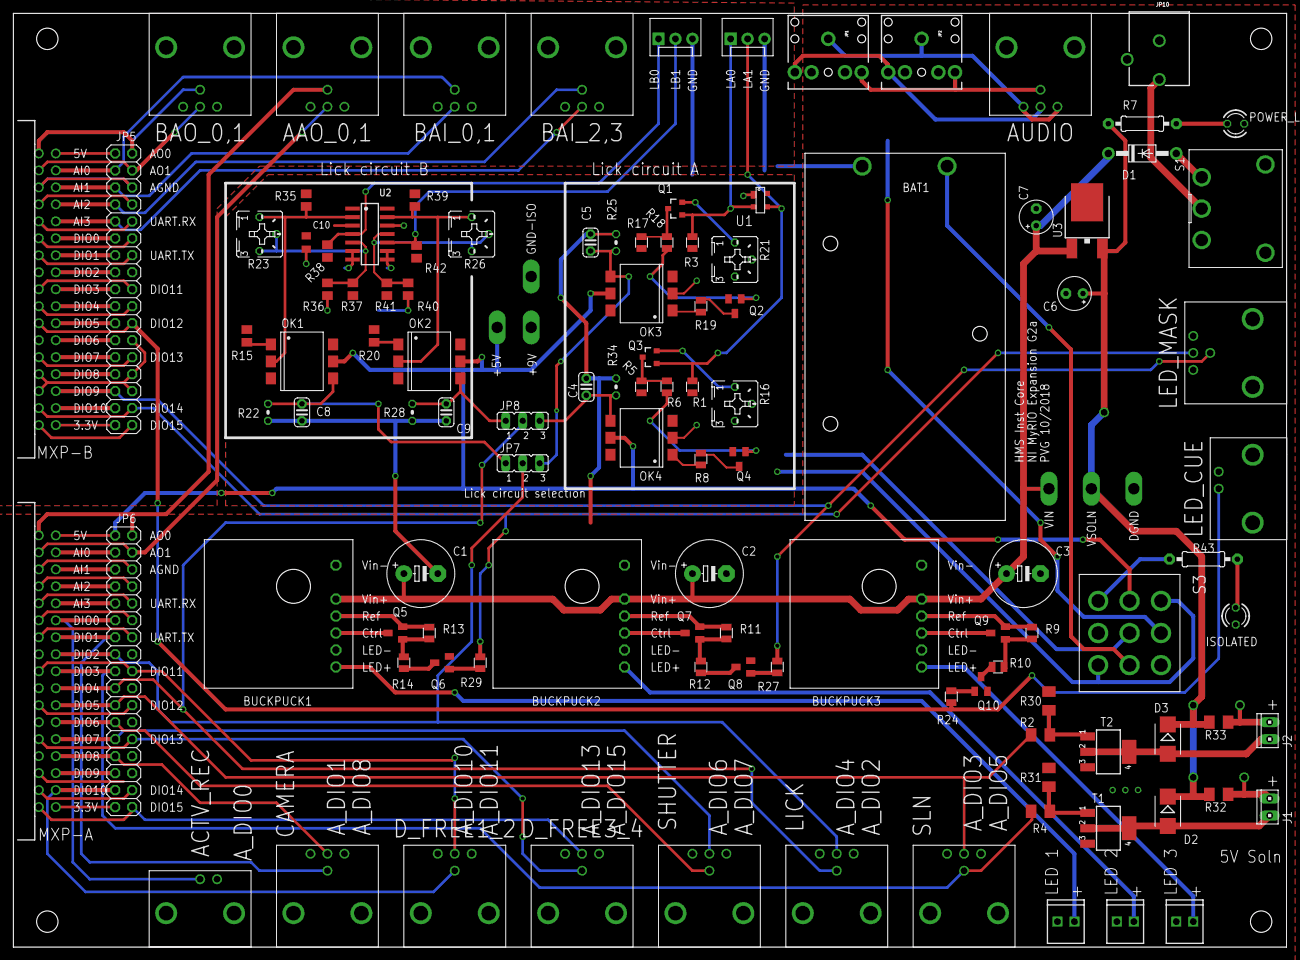
[picture p11: board MyRIO_Breakout_Gamma2b.brd from above]

Board: 2 copper layers, 190.5 x 139.7 mm, 119 parts (0 on the bottom side), 116 nets.
