HMS-RIC/MyRIO_Breakout/(notices)

Notices in the files:
parts and their libraries:
SparkFun-Connectors: Licensing: Creative Commons ShareAlike 4.0 International - https://creativecommons.org/licenses/by-sa/4.0
op-amp: Copyright (C) 2015, Bob Starr
